Mahd-H/Moodboard/media/assembly.png

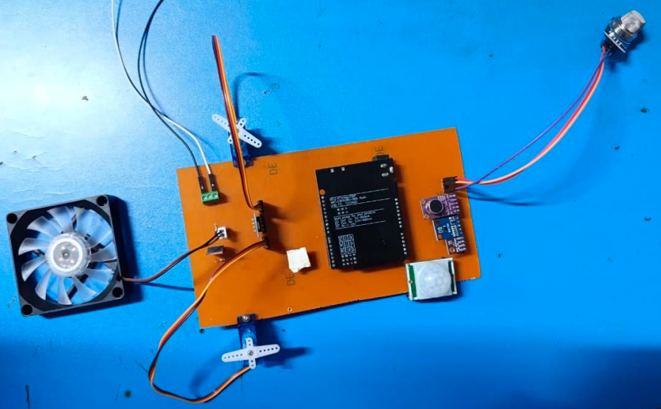
media/assembly.png
